Sarando07/IFS09-uDV-PCB/MicroDV2.kicad_pcb

## KiCad design MicroDV2.kicad_pcb (2026-11-09)

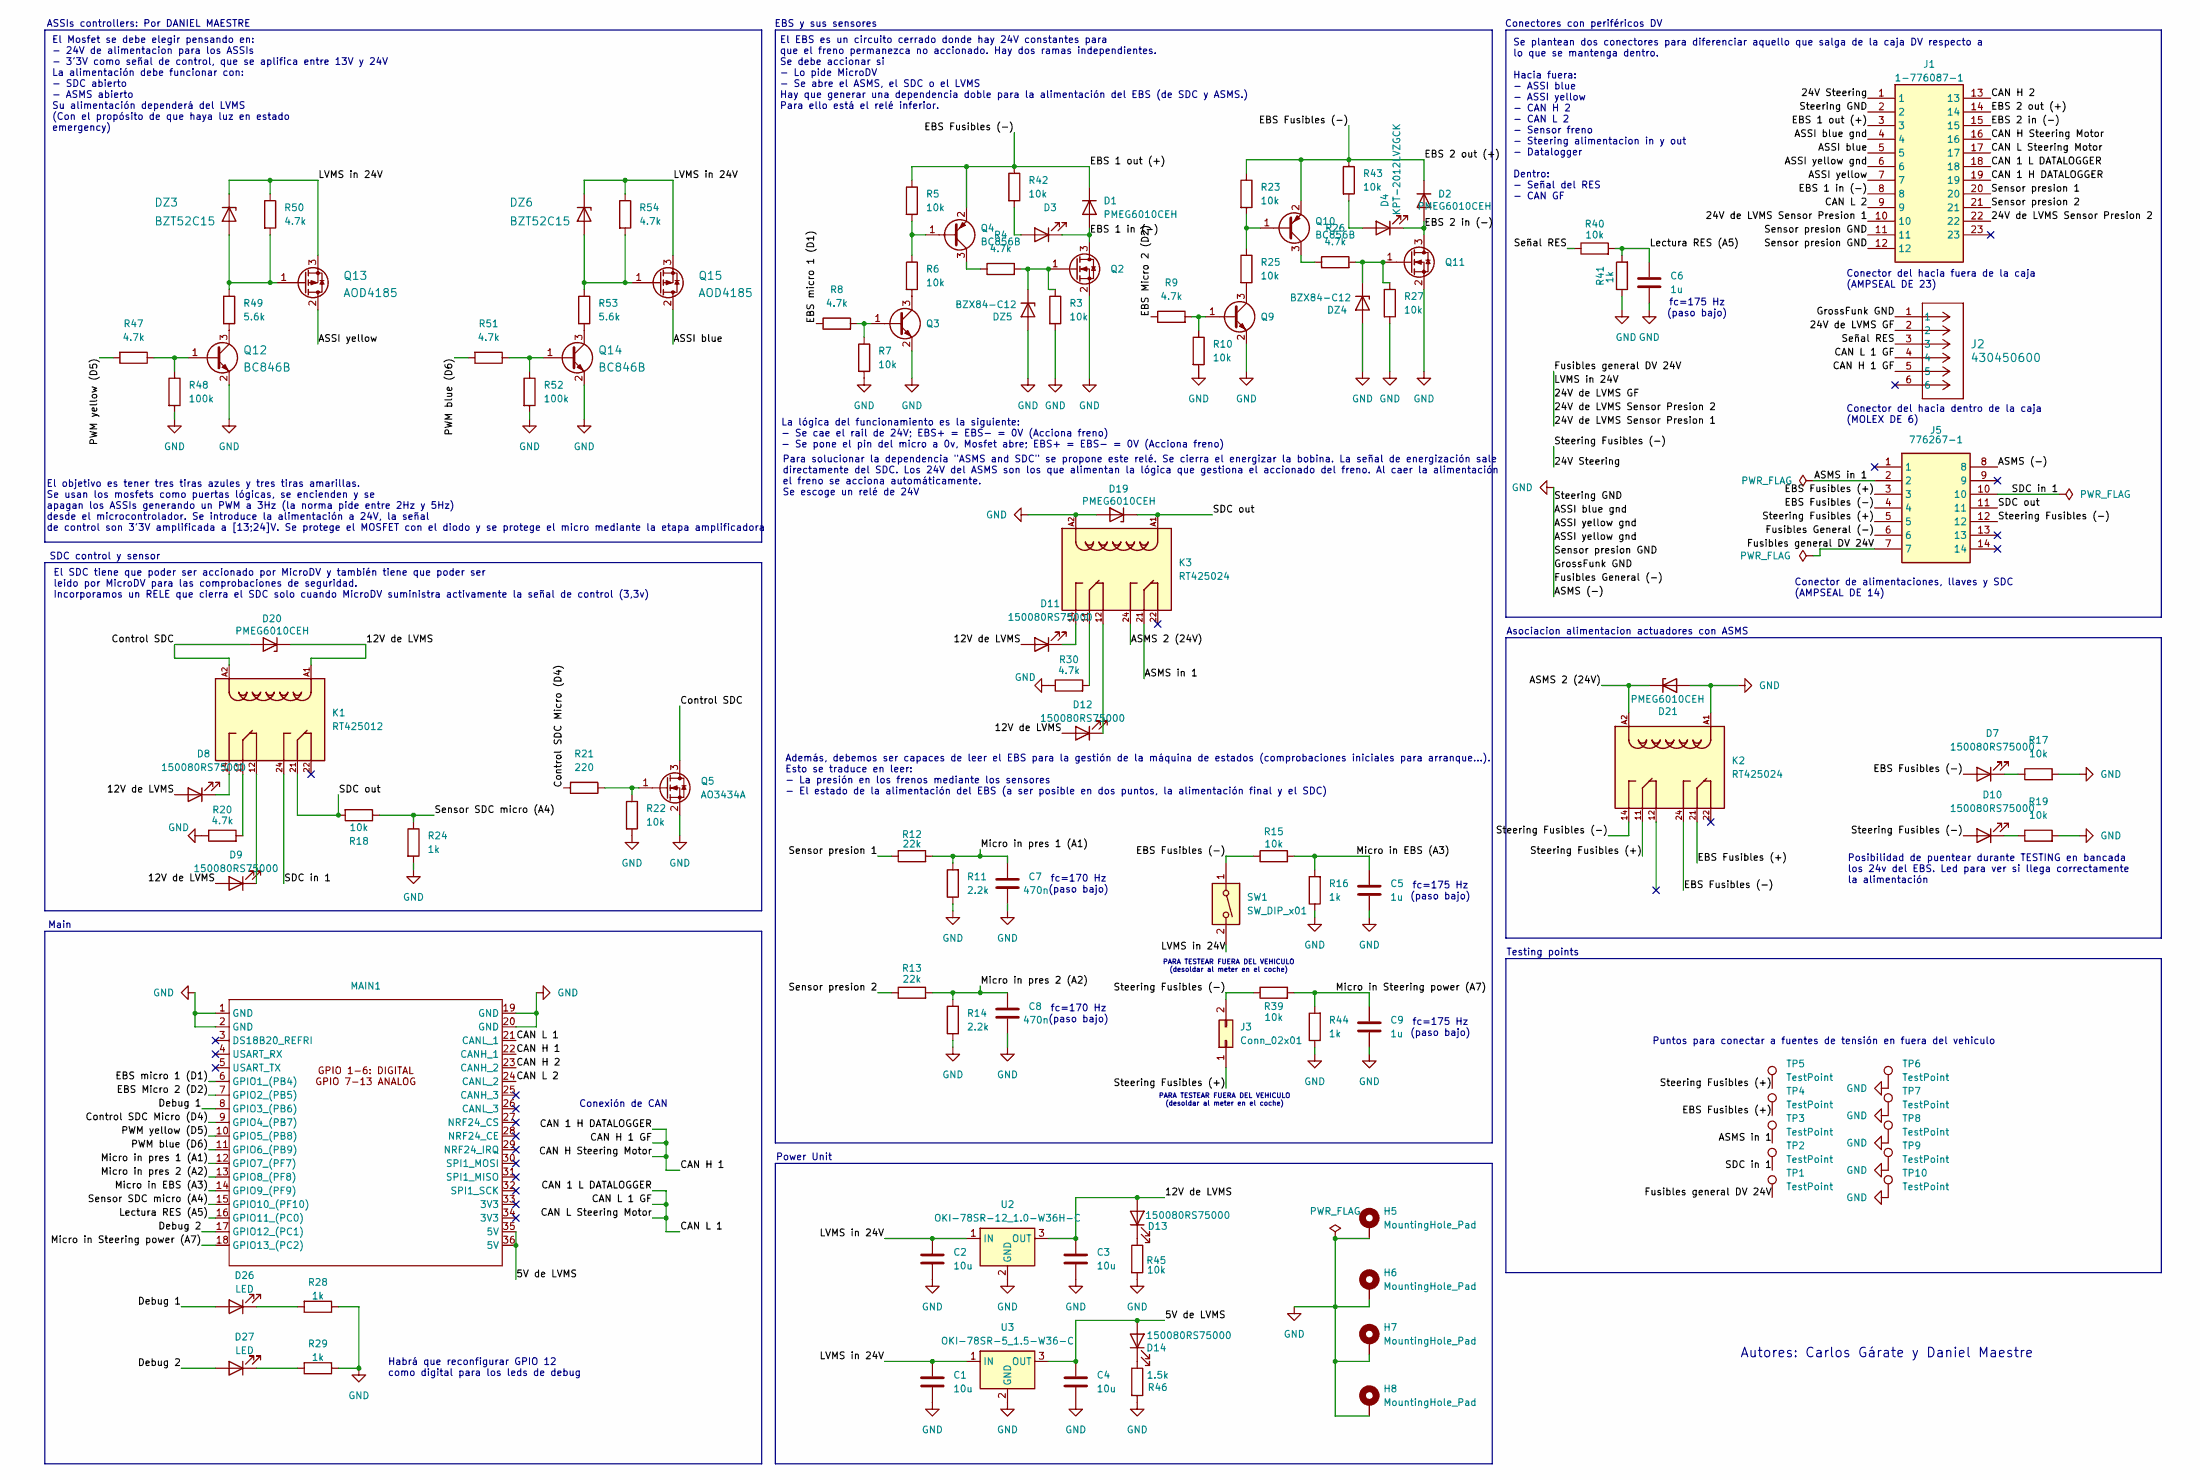
[picture p1: schematic MicroDV2.kicad_sch]

Parts:
C1, C2, C3, C4: 10u; C_0805_2012Metric
C5, C6, C9: 1u; C_0805_2012Metric
C7, C8: 470n; C_0805_2012Metric
D1, D2, D19, D20, D21: PMEG6010CEH; D_SOD-123F
D3, D4: KPT-2012LVZGCK; LED_0805_2012Metric
D7, D8, D9, D10, D11, D12, D13, D14: 150080RS75000; 150080RS75000_WRE
D26, D27: LED; 150080RS75000_WRE
DZ3, DZ6: BZT52C15; D_SOD-123
DZ4, DZ5: BZX84-C12; SOT-23
H5, H6, H7, H8: MountingHole_Pad; MountingHole_3.2mm_M3_DIN965_Pad
J1: 1-776087-1; 17760871; Mouser Part Number 571-1-776087-1
J2: 430450600; CON_430450600_MOL
J3: Conn_02x01; AMASS_XT60-F_1x02_P7.20mm_Vertical
J5: 776267-1; Manufacturer_Part_Number 776267-1
K1: RT425012; Relay_DPDT_Schrack-RT2-FormC_RM5mm; PARTREV 04-11
K2, K3: RT425024; Relay_DPDT_Schrack-RT2-FormC_RM5mm
MAIN1: MAIN_LITE
Q2, Q11: PMV37ENEA; SOT-23
Q3, Q9, Q12, Q14: BC846B; SOT-23
Q4, Q10: BC856B; SOT-23
Q5: AO3434A; SOT-23
Q13, Q15: AOD4185; TO-252-2
R3, R5, R6, R7, R10, R15, R17, R18, R19, R22, R23, R25, R27, R39, R40, R42, R43, R45: 10k; 0805_PAN
R4, R8, R9, R20, R26, R30, R47, R50, R51, R54: 4.7k; 0805_PAN
R11, R14: 2.2k; 0805_PAN
R12, R13: 22k; 0805_PAN
R16, R24, R28, R29, R41, R44: 1k; 0805_PAN
R21: 220; 0805_PAN
R46: 1.5k; 0805_PAN
R48, R52: 100k; 0805_PAN
R49, R53: 5.6k; 0805_PAN
SW1: SW_DIP_x01; SW_DIP_SPSTx01_Slide_9.78x4.72mm_W7.62mm_P2.54mm
TP1, TP2, TP3, TP4, TP5, TP6, TP7, TP8, TP9, TP10: TestPoint; TestPoint_Keystone_5000-5004_Miniature
U2: OKI-78SR-12_1.0-W36H-C; Converter_DCDC_Murata_OKI-78SR_Horizontal
U3: OKI-78SR-5_1.5-W36-C; Converter_DCDC_Murata_OKI-78SR_Vertical

Connections:
/5V de LVMS: C4.1, D14.2 (A), MAIN1.35 (5V), MAIN1.36 (5V), U3.3 (OUT)
/12V de LVMS: C3.1, D8.2 (A), D9.2 (A), D11.2 (A), D12.2 (A), D13.2 (A), D20.1 (K), K1.A1, U2.3 (OUT)
/24V Steering: D10.2 (A), J1.1, J3.2, J5.12, K2.14, R39.1
/24V de LVMS GF: C1.1, C2.1, DZ3.1 (K), DZ6.1 (K), J1.10, J1.22, J2.2, J5.7, Q13.3 (S), Q15.3 (S), R50.1, R54.1, SW1.2, TP1.1 (1_1), U2.1 (IN), U3.1 (IN)
/ASMS 2 (24V): D21.1 (K), K2.A2, K3.24
/ASMS in 1: J5.2, K3.21, TP3.1 (1_1)
/ASSI blue: J1.5, Q15.2 (D)
/ASSI yellow: J1.7, Q13.2 (D)
/CAN 1 H DATALOGGER: J1.16, J1.19, J2.5, MAIN1.22 (CANH_1)
/CAN 1 L DATALOGGER: J1.17, J1.18, J2.4, MAIN1.21 (CANL_1)
/CAN H 2: J1.13, MAIN1.23 (CANH_2)
/CAN L 2: J1.9, MAIN1.24 (CANL_2)
/Control SDC: D20.2 (A), K1.A2, Q5.3 (D)
/Control SDC Micro (D4): MAIN1.9 (GPIO4_(PB7)), R21.2
/Debug 1: D26.2 (A), MAIN1.8 (GPIO3_(PB6))
/Debug 2: D27.2 (A), MAIN1.17 (GPIO12_(PC1))
/EBS 1 in (-): D1.2 (A), D3.1 (K), J1.8, Q2.3 (D)
/EBS 1 out (+): D1.1 (K), D2.1 (K), D7.2 (A), J1.3, J1.14, J5.4, K2.24, Q4.2 (E), Q10.2 (E), R5.1, R15.1, R23.1, R42.1, R43.1, SW1.1
/EBS 2 in (-): D2.2 (A), D4.1 (K), J1.15, Q11.3 (D)
/EBS Fusibles (+): J5.3, K2.21, TP4.1 (1_1)
/EBS Micro 2 (D2): MAIN1.7 (GPIO2_(PB5)), R9.1
/EBS micro 1 (D1): MAIN1.6 (GPIO1_(PB4)), R8.1
/Lectura RES (A5): C6.1, MAIN1.16 (GPIO11_(PC0)), R40.2, R41.2
/Micro in EBS (A3): C5.1, MAIN1.14 (GPIO9_(PF9)), R15.2, R16.2
/Micro in Steering power (A7): C9.1, MAIN1.18 (GPIO13_(PC2)), R39.2, R44.2
/Micro in pres 1 (A1): C7.1, MAIN1.12 (GPIO7_(PF7)), R11.2, R12.2
/Micro in pres 2 (A2): C8.1, MAIN1.13 (GPIO8_(PF8)), R13.2, R14.2
/PWM blue (D6): MAIN1.11 (GPIO6_(PB9)), R51.2
/PWM yellow (D5): MAIN1.10 (GPIO5_(PB8)), R47.2
/SDC in 1: J5.10, K1.24, TP2.1 (1_1)
/SDC out: D19.1 (K), J5.11, K1.21, K3.A1, R18.2
/Sensor SDC micro (A4): MAIN1.15 (GPIO10_(PF10)), R18.1, R24.1
/Sensor presion 1: J1.20, R12.1
/Sensor presion 2: J1.21, R13.1
/Señal RES: J2.3, R40.1
/Steering Fusibles (+): J3.1, J5.5, K2.11, TP5.1 (1_1)
GND: C1.2, C2.2, C3.2, C4.2, C5.2, C6.2, C7.2, C8.2, C9.2, D19.2 (A), D21.2 (A), DZ4.1 (A), DZ5.1 (A), H5.1 (1_1), H6.1 (1_1), H7.1 (1_1), H8.1 (1_1), J1.2, J1.4, J1.6, J1.11, J1.12, J2.1, J5.6, J5.8, K2.A1, K3.A2, MAIN1.1 (GND), MAIN1.2 (GND), MAIN1.19 (GND), MAIN1.20 (GND), Q2.2 (S), Q3.2 (E), Q5.2 (S), Q9.2 (E), Q11.2 (S), Q12.2 (E), Q14.2 (E), R3.2, R7.2, R10.2, R11.1, R14.1, R16.1, R17.2, R19.2, R20.1, R22.2, R24.2, R27.2, R28.1, R29.1, R30.1, R41.1, R44.1, R45.2, R46.2, R48.2, R52.2, TP6.1 (1_1), TP7.1 (1_1), TP8.1 (1_1), TP9.1 (1_1), TP10.1 (1_1), U2.2 (GND), U3.2 (GND)
unnamed: D3.2 (A), R42.2
unnamed: D4.2 (A), R43.2
unnamed: D7.1 (K), R17.1
unnamed: D8.1 (K), K1.14
unnamed: D9.1 (K), K1.12
unnamed: D10.1 (K), R19.1
unnamed: D11.1 (K), K3.14
unnamed: D12.1 (K), K3.12
unnamed: D13.1 (K), R45.1
unnamed: D14.1 (K), R46.1
unnamed: D26.1 (K), R28.2
unnamed: D27.1 (K), R29.2
unnamed: DZ3.2 (A), Q13.1 (G), R49.1, R50.2
unnamed: DZ4.3 (K), Q11.1 (G), R26.2, R27.1
unnamed: DZ5.3 (K), Q2.1 (G), R3.1, R4.2
unnamed: DZ6.2 (A), Q15.1 (G), R53.1, R54.2
unnamed: K1.11, R20.2
unnamed: K3.11, R30.2
unnamed: Q3.1 (B), R7.1, R8.2
unnamed: Q3.3 (C), R6.2
unnamed: Q4.1 (B), R5.2, R6.1
unnamed: Q4.3 (C), R4.1
unnamed: Q5.1 (G), R21.1, R22.1
unnamed: Q9.1 (B), R9.2, R10.1
unnamed: Q9.3 (C), R25.2
unnamed: Q10.1 (B), R23.2, R25.1
unnamed: Q10.3 (C), R26.1
unnamed: Q12.1 (B), R47.1, R48.1
unnamed: Q12.3 (C), R49.2
unnamed: Q14.1 (B), R51.1, R52.1
unnamed: Q14.3 (C), R53.2

Notes on the sheet:
fc=175 Hz (paso bajo)
fc=170 Hz (paso bajo)
Puntos para conectar a fuentes de tensión en fuera del vehiculo
Además, debemos ser capaces de leer el EBS para la gestión de la máquina de estados (comprobaciones iniciales para arranque...). Esto se traduce en leer: - La presión en los frenos mediante los sensores - El estado de la alimentación del EBS (a ser posible en dos puntos, la alimentación final y el 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
Para solucionar la dependencia "ASMS and SDC" se propone este relé. Se cierra el energizar la bobina. La señal de energización sale directamente del SDC. Los 24V del ASMS son los que alimentan la lógica que gestiona el accionado del freno. Al caer la alimentación el freno se acciona automáticamente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
Conector del hacia fuera de la caja (AMPSEAL DE 23)
Conector del hacia dentro de la caja (MOLEX DE 6)
Main
Conector de alimentaciones, llaves y SDC (AMPSEAL DE 14)
Habrá que reconfigurar GPIO 12 como digital para los leds de debug
Power Unit
Autores: Carlos Gárate y Daniel Maestre
Posibilidad de puentear durante TESTING en bancada los 24v del EBS. Led para ver si llega correctamente la alimentación
El SDC tiene que poder ser accionado por MicroDV y también tiene que poder ser leido por MicroDV para las comprobaciones de seguridad. Incorporamos un RELE que cierra el SDC solo cuando MicroDV suministra activamente la señal de control (3,3v)
Conexión de CAN
Se plantean dos conectores para diferenciar aquello que salga de la caja DV respecto a lo que se mantenga dentro. Hacia fuera: - ASSI blue - ASSI yellow - CAN H 2 - CAN L 2 - Sensor freno - Steering alimentacion in y out - Datalogger Dentro: - Señal del RES - CAN GF
PARA TESTEAR FUERA DEL VEHICULO (desoldar al meter en el coche)
El EBS es un circuito cerrado donde hay 24V constantes para que el freno permanezca no accionado. Hay dos ramas independientes. Se debe accionar si - Lo pide MicroDV - Se abre el ASMS, el SDC o el LVMS Hay que generar una dependencia doble para la alimentación del EBS (de SDC y ASMS.) Para ello est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
La lógica del funcionamiento es la siguiente: - Se cae el rail de 24V; EBS+ = EBS- = 0V (Acciona freno) - Se pone el pin del micro a 0v, Mosfet abre; EBS+ = EBS- = 0V (Acciona freno)
El Mosfet se debe elegir pensando en: - 24V de alimentacion para los ASSIs - 3'3V como señal de control, que se aplifica entre 13V y 24V La alimentación debe funcionar con: - SDC abierto - ASMS abierto Su alimentación dependerá del LVMS (Con el propósito de que haya luz en estado emergency)
ASSIs controllers: Por DANIEL MAESTRE
SDC control y sensor
Conectores con periféricos DV
El objetivo es tener tres tiras azules y tres tiras amarillas. Se usan los mosfets como puertas lógicas, se encienden y se apagan los ASSIs generando un PWM a 3Hz (la norma pide entre 2Hz y 5Hz) desde el microcontrolador. Se introduce la alimentación a 24V, la señal de control son 3'3V amplificada 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
Asociacion alimentacion actuadores con ASMS
Testing points
EBS y sus sensores

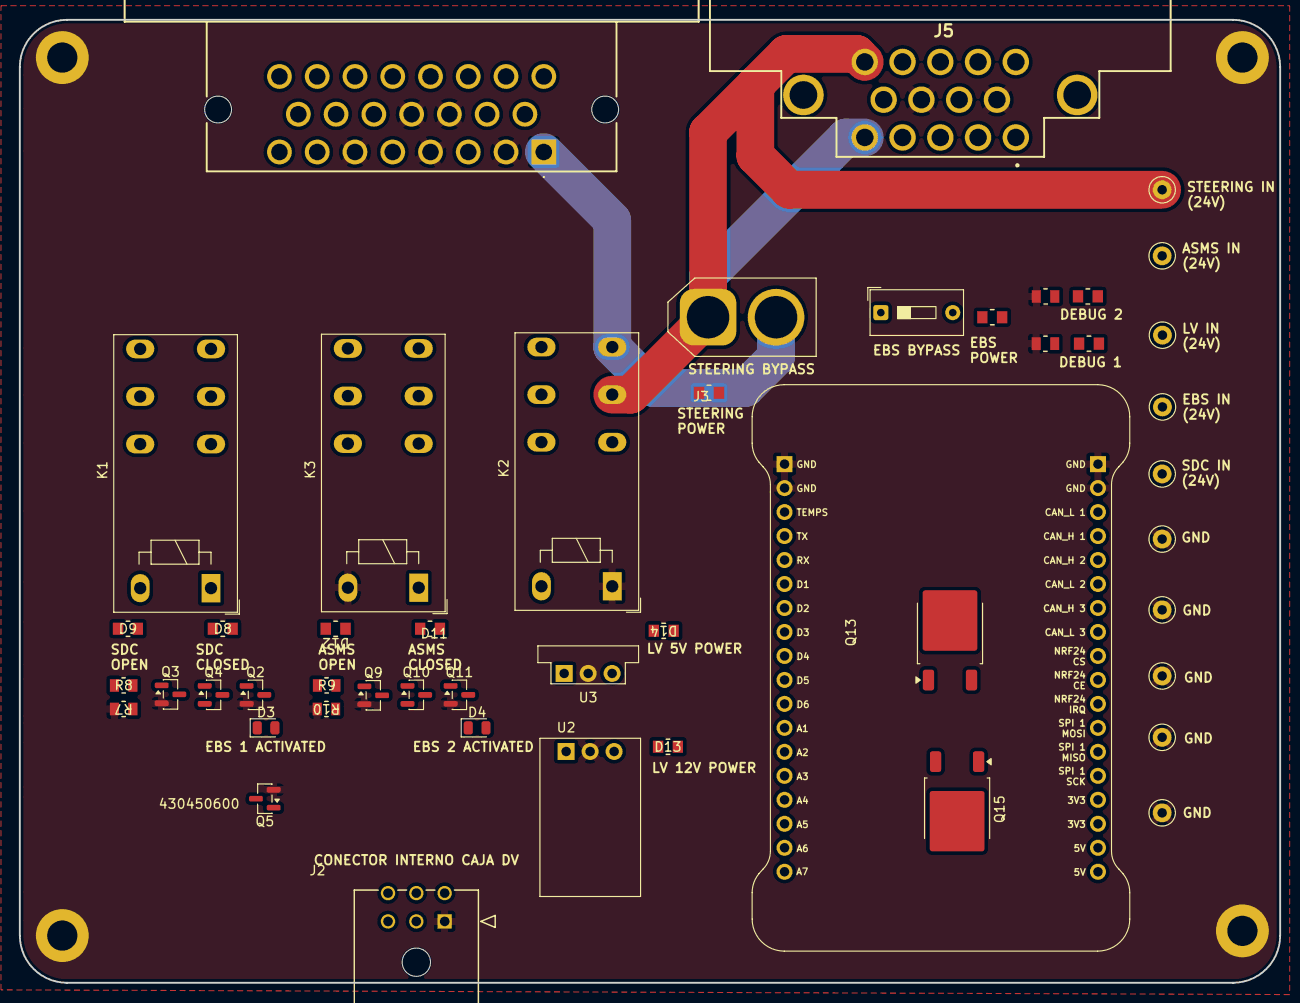
[picture p2: board MicroDV2.kicad_pcb from above]

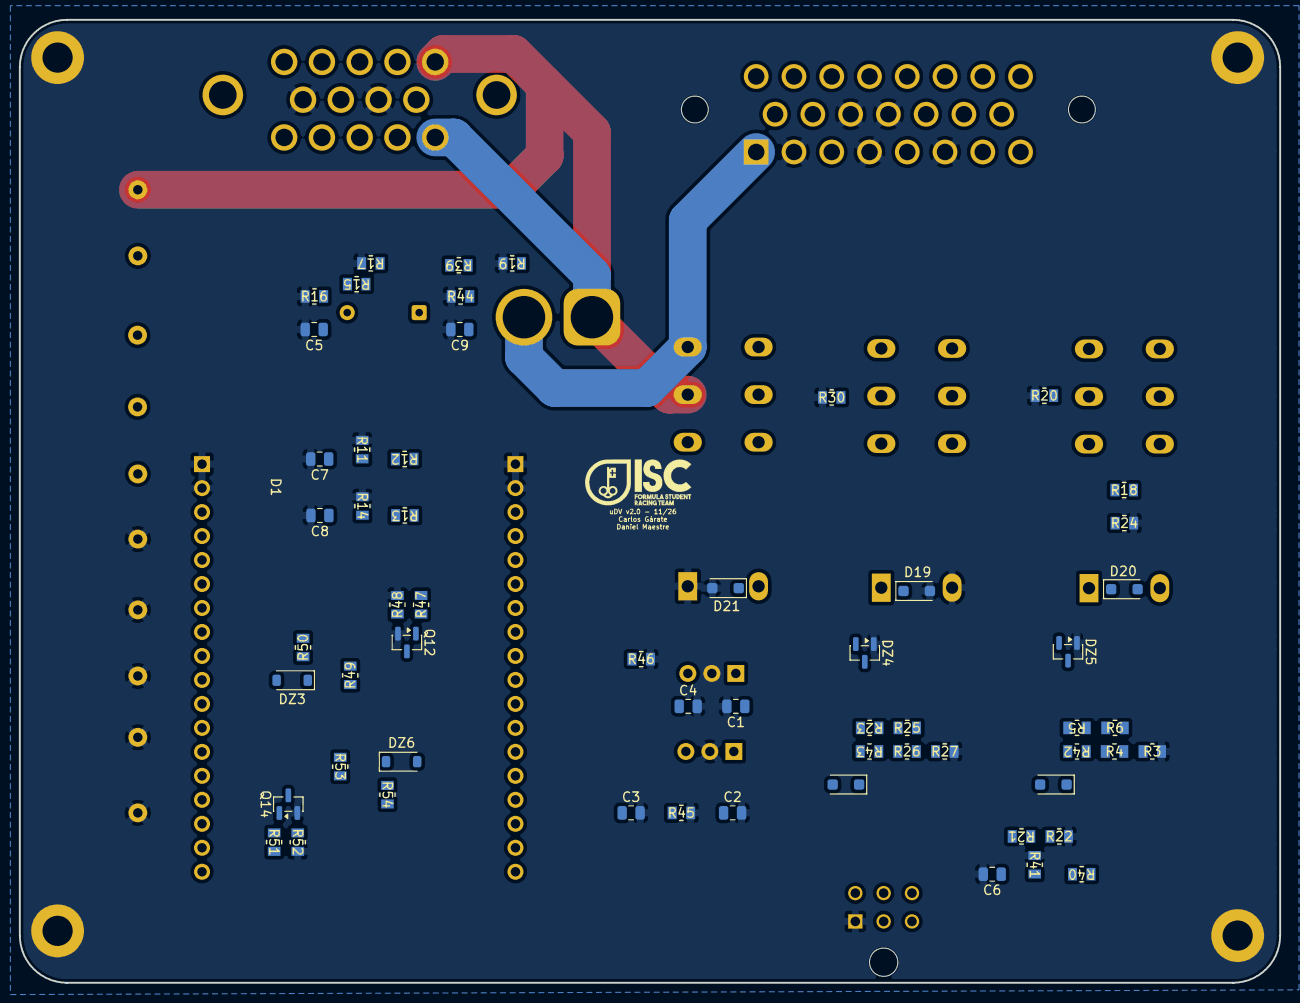
[picture p3: board MicroDV2.kicad_pcb from below]

Board: 2 copper layers, 133.5 x 102.0 mm, 111 parts (59 on the bottom side), 68 nets.

Other parts of the board:
G3: LOGO; LogoISC
