Sarando07/IFS09-uDV-PCB/(commit log)

2026-11-08 uDV PCB first upload
    [MicroDV2.kicad_pcb, MicroDV2.kicad_sch]
2026-11-09 Ancho de placa nuevo
    [MicroDV2.kicad_pcb, MicroDV2.kicad_sch]
2026-11-09 Ancho de placa nuevo skinny
    [MicroDV2.kicad_pcb]
